kagouraki/PypilotRemote/3dparts/St70ScreenAdapter.STEP

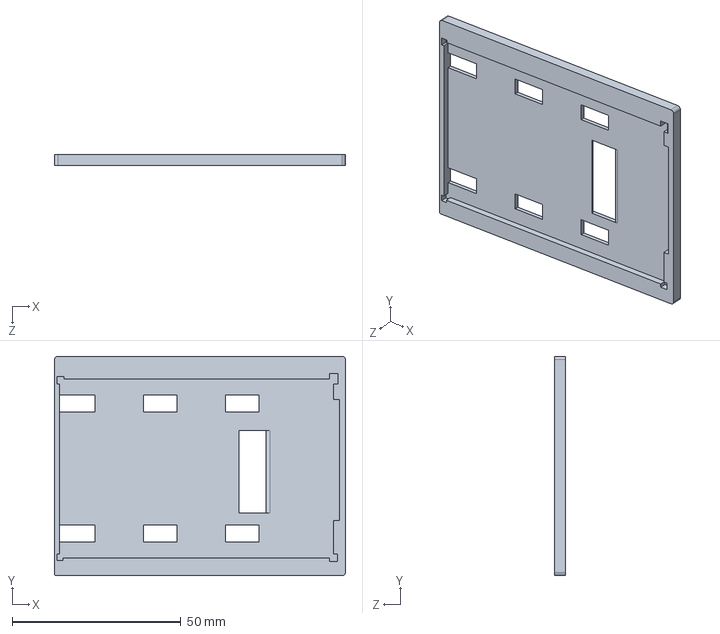
[picture p6: CAD file, 2026-01-31]
3dparts/St70ScreenAdapter.STEP
86.2 x 65.0 x 3.20 mm
