kagouraki/PypilotRemote/pcb/raymarineST70/st70Remote/schematic.pdf

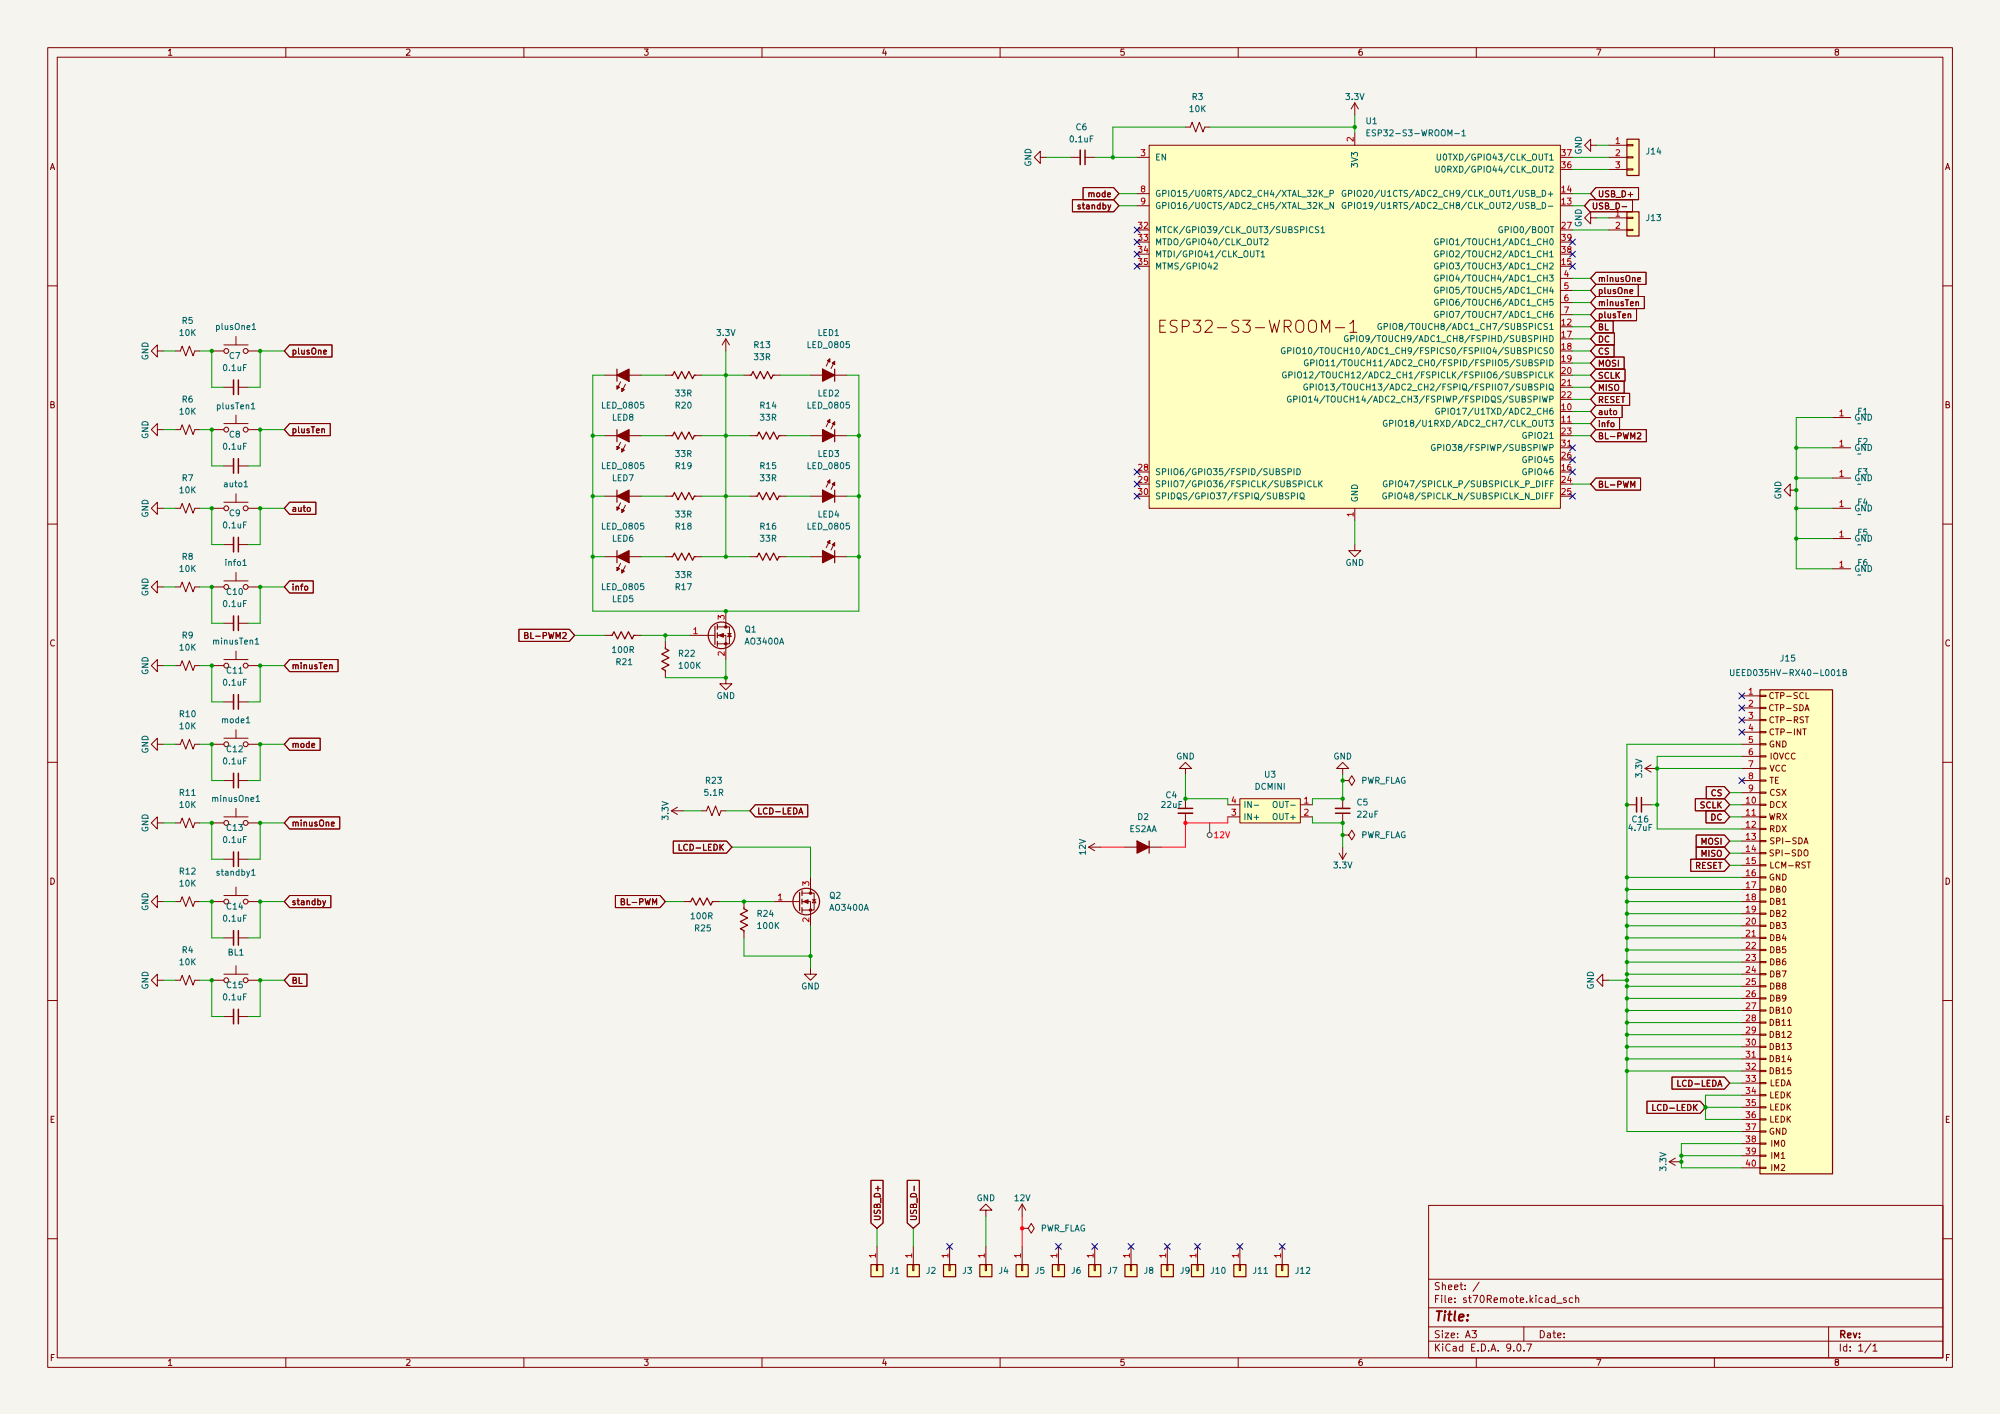
[picture p7: page 1]
