kagouraki/PypilotRemote/(list of files, drawings)

Other design files:
pcb/raymarineST70/st70Remote/freerouting.dsn
