kagouraki/PypilotRemote/pcb/raymarineST70/st70Remote/st70Remote.kicad_pcb

## KiCad design pcb/raymarineST70/st70Remote/st70Remote.kicad_pcb (2026-01-31)

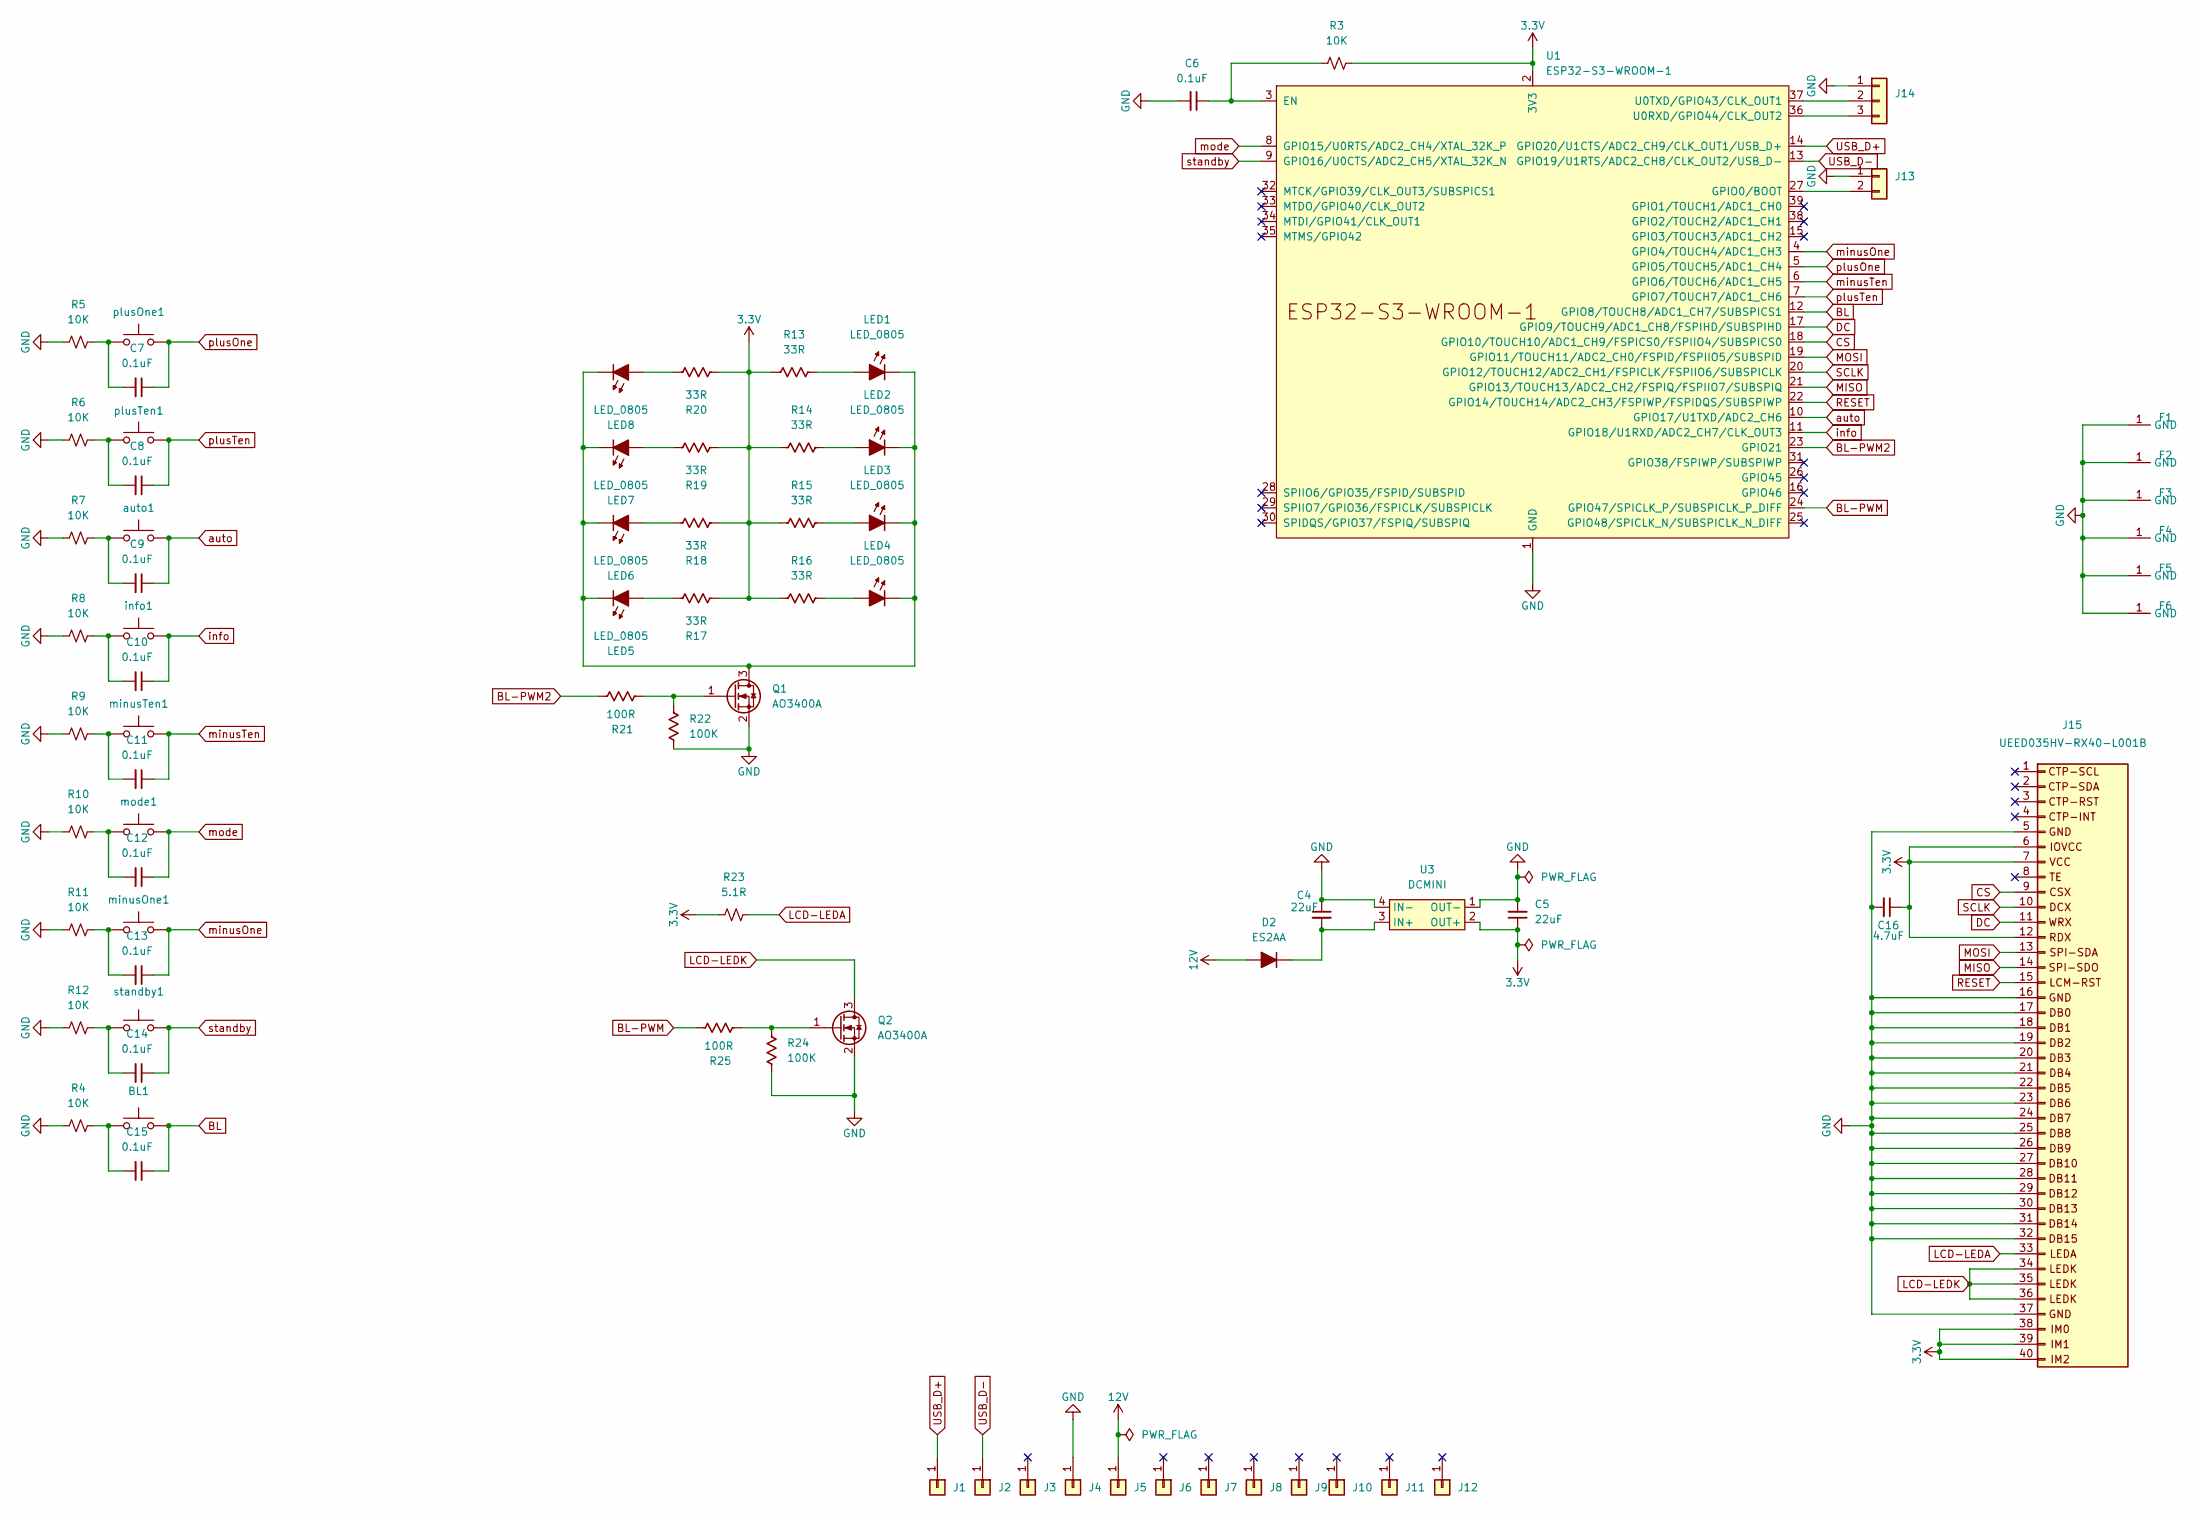
[picture p8: schematic st70Remote.kicad_sch]

Parts:
BL1: SMD_6.2x6.2mm_h7.0mm; Push_SMD_6.2x6.2mm; Mfg Part# 679-2384-2-ND
C4, C5: 22uF; C_1206_3216Metric_Pad1.42x1.75mm; Voltage 25V; Tolerance 10%
C6, C7, C8, C9, C10, C11, C12, C13, C14, C15: 0.1uF; C_0805_2012Metric; Voltage 25V; Tolerance 5%
C16: 4.7uF; C_0805_2012Metric; Voltage 25V; Tolerance 5%
D2: ES2AA; D_SMA
F1, F2, F3, F4, F5, F6: Harwin S1791-42R
J1, J2, J3, J4, J5, J6, J7, J8, J9, J10, J11, J12: Conn_01x01; 1x01_P2.54mm
J13: Conn_01x02; 1x02_P2.54mm
J14: Conn_01x03; 1x03_P2.54mm_Locking
J15: UEED035HV-RX40-L001B; XUNPU FPC-05F-40PH20
LED1, LED2, LED3, LED4, LED5, LED6, LED7, LED8: LED_0805; LED_0805_2012Metric
Q1, Q2: AO3400A; SOT-23
R3, R4, R5, R6, R7, R8, R9, R10, R11, R12: 10K; R_0805_2012Metric
R13, R14, R15, R16, R17, R18, R19, R20: 33R; R_0805_2012Metric
R21, R25: 100R; R_0805_2012Metric
R22, R24: 100K; R_0805_2012Metric
R23: 5.1R; R_0805_2012Metric
U1: ESP32-S3-WROOM-1; ESP32-S3-WROOM-1U
U3: DCMINI
auto1: SMD_6.2x6.2mm_h7.0mm; Push_SMD_6.2x6.2mm; Mfg Part# 679-2384-2-ND
info1: SMD_6.2x6.2mm_h7.0mm; Push_SMD_6.2x6.2mm; Mfg Part# 679-2384-2-ND
minusOne1: SMD_6.2x6.2mm_h7.0mm; Push_SMD_6.2x6.2mm; Mfg Part# 679-2384-2-ND
minusTen1: SMD_6.2x6.2mm_h7.0mm; Push_SMD_6.2x6.2mm; Mfg Part# 679-2384-2-ND
mode1: SMD_6.2x6.2mm_h7.0mm; Push_SMD_6.2x6.2mm; Mfg Part# 679-2384-2-ND
plusOne1: SMD_6.2x6.2mm_h7.0mm; Push_SMD_6.2x6.2mm; Mfg Part# 679-2384-2-ND
plusTen1: SMD_6.2x6.2mm_h7.0mm; Push_SMD_6.2x6.2mm; Mfg Part# 679-2384-2-ND
standby1: SMD_6.2x6.2mm_h7.0mm; Push_SMD_6.2x6.2mm; Mfg Part# 679-2384-2-ND

Connections:
3.3V: C5.1, C16.1, J15.6, J15.7, J15.12, J15.38, J15.39, J15.40, R3.1, R13.1, R14.1, R15.1, R16.1, R17.1, R18.1, R19.1, R20.1, R23.2, U1.2 (3V3), U3.2 (OUT+)
12V: D2.2 (A), J5.1
BL: BL1.2, C15.1, U1.12 (GPIO8/TOUCH8/ADC1_CH7/SUBSPICS1)
BL-PWM: R25.2, U1.24 (GPIO47/SPICLK_P/SUBSPICLK_P_DIFF)
BL-PWM2: R21.2, U1.23 (GPIO21)
CS: J15.9, U1.18 (GPIO10/TOUCH10/ADC1_CH9/FSPICS0/FSPIIO4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)
DC: J15.11, U1.17 (GPIO9/TOUCH9/ADC1_CH8/FSPIHD/SUBSPIHD)
GND: C4.1, C5.2, C6.2, C16.2, F1.1 (GND), F2.1 (GND), F3.1 (GND), F4.1 (GND), F5.1 (GND), F6.1 (GND), J4.1, J13.1, J14.1, J15.5, J15.16, J15.17, J15.18, J15.19, J15.20, J15.21, J15.22, J15.23, J15.24, J15.25, J15.26, J15.27, J15.28, J15.29, J15.30, J15.31, J15.32, J15.37, J15.41 (GND), Q1.2 (S), Q2.2 (S), R4.2, R5.2, R6.2, R7.2, R8.2, R9.2, R10.2, R11.2, R12.2, R22.2, R24.2, U1.1 (GND), U1.40 (GND), U1.41 (GND), U3.1 (OUT-), U3.4 (IN-)
LCD-LEDA: J15.33, R23.1
LCD-LEDK: J15.34, J15.35, J15.36, Q2.3 (D)
MISO: J15.14, U1.21 (GPIO13/TOUCH13/ADC2_CH2/FSPIQ/FSPIIO7/S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)
MOSI: J15.13, U1.19 (GPIO11/TOUCH11/ADC2_CH0/FSPID/FSPIIO5/S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)
unnamed: BL1.1, C15.2, R4.1
unnamed: C7.2, R5.1, plusOne1.1
unnamed: C8.2, R6.1, plusTen1.1
unnamed: C9.2, R7.1, auto1.1
unnamed: C10.2, R8.1, info1.1
unnamed: C11.2, R9.1, minusTen1.1
unnamed: C12.2, R10.1, mode1.1
unnamed: C13.2, R11.1, minusOne1.1
unnamed: C14.2, R12.1, standby1.1
unnamed: C4.2, D2.1 (K), U3.3 (IN+)
unnamed: J13.2, U1.27 (GPIO0/BOOT)
unnamed: J14.2, U1.37 (U0TXD/GPIO43/CLK_OUT1)
unnamed: J14.3, U1.36 (U0RXD/GPIO44/CLK_OUT2)
unnamed: LED1.2 (A), R13.2
unnamed: LED1.1 (K), LED2.1 (K), LED3.1 (K), LED4.1 (K), LED5.1 (K), LED6.1 (K), LED7.1 (K), LED8.1 (K), Q1.3 (D)
unnamed: LED2.2 (A), R14.2
unnamed: LED3.2 (A), R15.2
unnamed: LED4.2 (A), R16.2
unnamed: LED5.2 (A), R17.2
unnamed: LED6.2 (A), R18.2
unnamed: LED7.2 (A), R19.2
unnamed: LED8.2 (A), R20.2
unnamed: Q1.1 (G), R21.1, R22.1
unnamed: Q2.1 (G), R24.1, R25.1
unnamed: C6.1, R3.2, U1.3 (EN)
RESET: J15.15, U1.22 (GPIO14/TOUCH14/ADC2_CH3/FSPIWP/FSPIDQS/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)
SCLK: J15.10, U1.20 (GPIO12/TOUCH12/ADC2_CH1/FSPICLK/FSPIIO6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)
USB_D+: J1.1, U1.14 (GPIO20/U1CTS/ADC2_CH9/CLK_OUT1/USB_D+)
USB_D-: J2.1, U1.13 (GPIO19/U1RTS/ADC2_CH8/CLK_OUT2/USB_D-)
auto: C9.1, U1.10 (GPIO17/U1TXD/ADC2_CH6), auto1.2
info: C10.1, U1.11 (GPIO18/U1RXD/ADC2_CH7/CLK_OUT3), info1.2
minusOne: C13.1, U1.4 (GPIO4/TOUCH4/ADC1_CH3), minusOne1.2
minusTen: C11.1, U1.6 (GPIO6/TOUCH6/ADC1_CH5), minusTen1.2
mode: C12.1, U1.8 (GPIO15/U0RTS/ADC2_CH4/XTAL_32K_P), mode1.2
plusOne: C7.1, U1.5 (GPIO5/TOUCH5/ADC1_CH4), plusOne1.2
plusTen: C8.1, U1.7 (GPIO7/TOUCH7/ADC1_CH6), plusTen1.2
standby: C14.1, U1.9 (GPIO16/U0CTS/ADC2_CH5/XTAL_32K_N), standby1.2

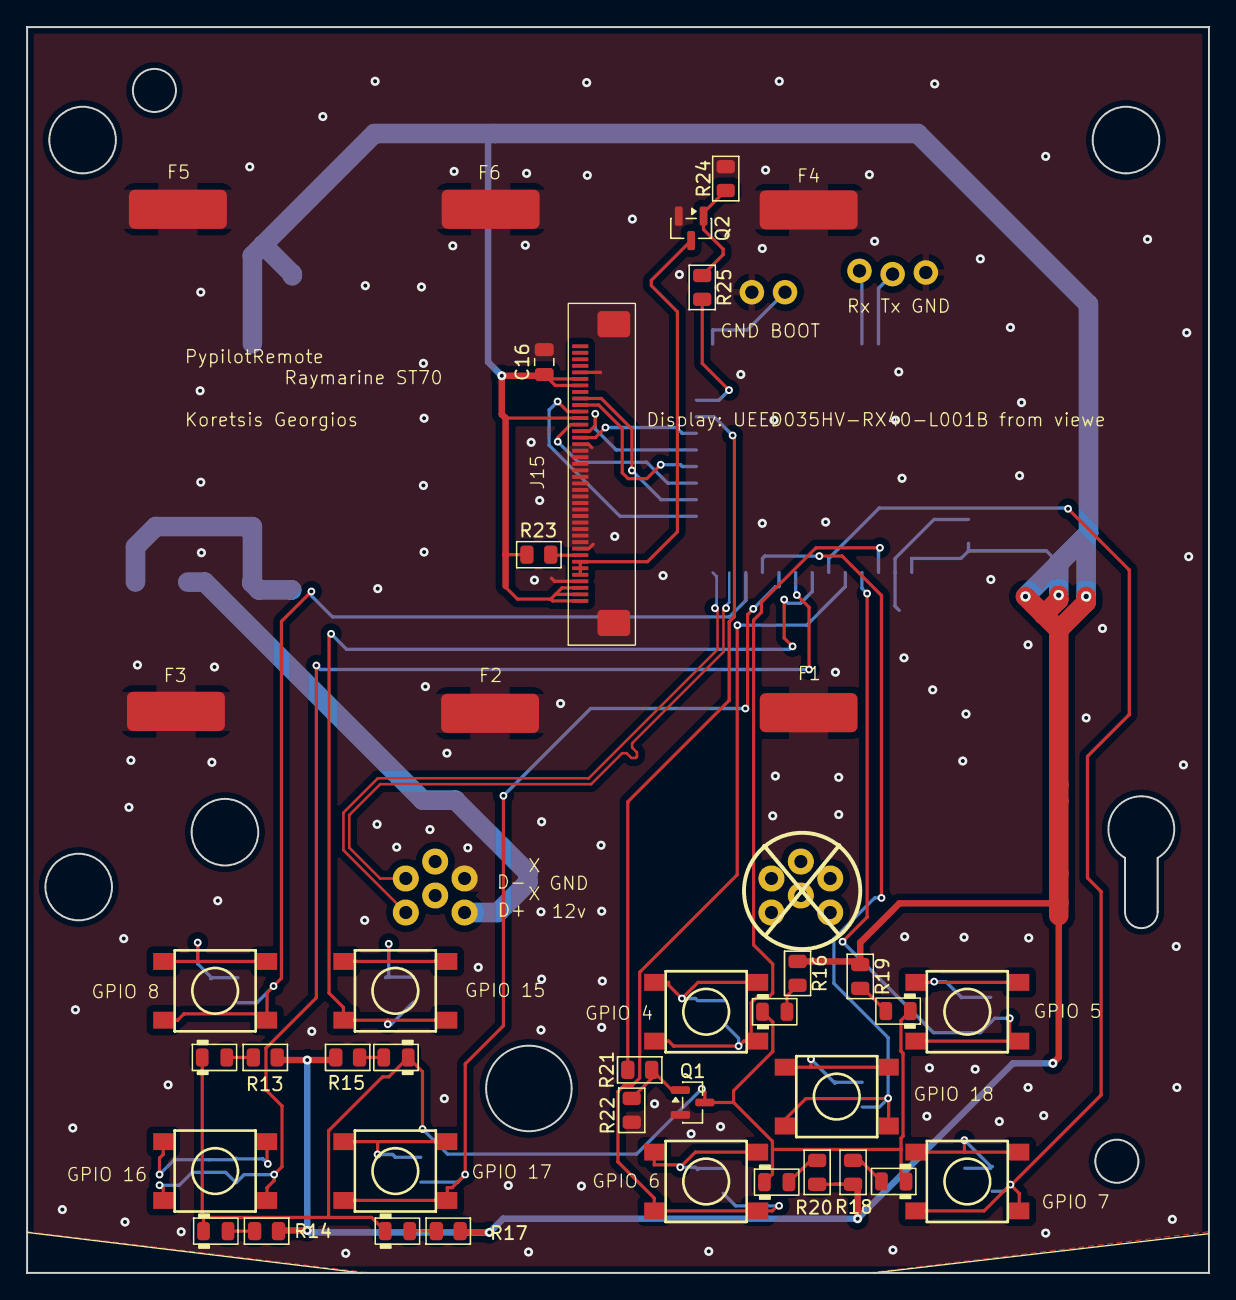
[picture p9: board st70Remote.kicad_pcb from above]

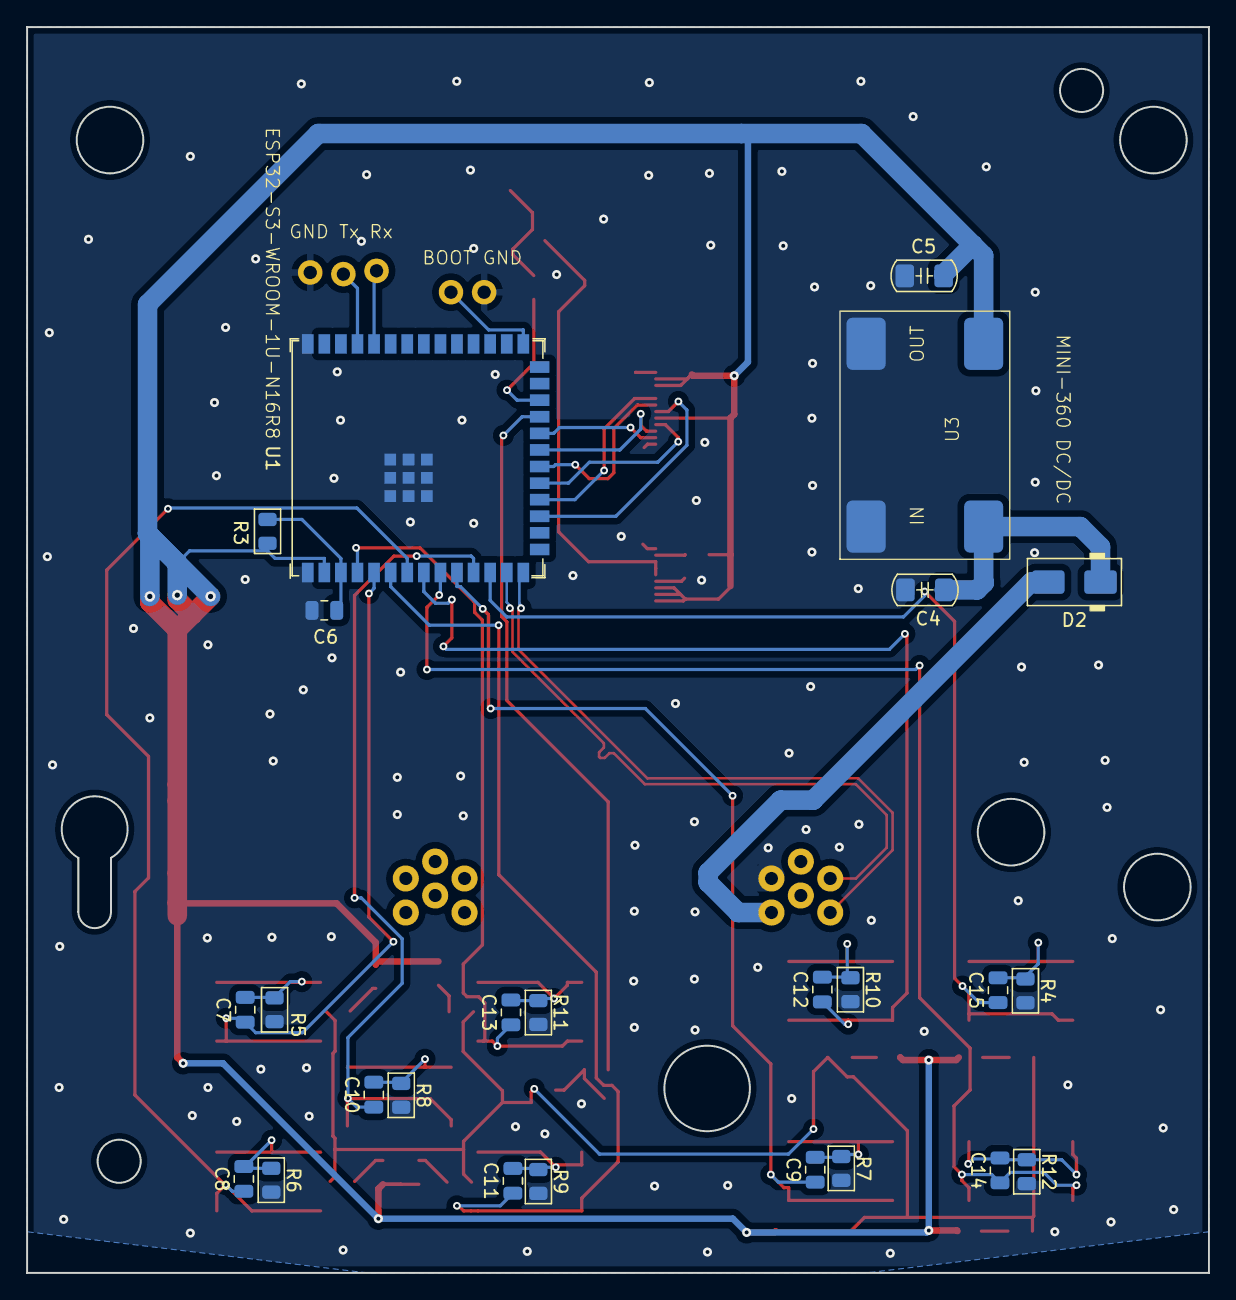
[picture p10: board st70Remote.kicad_pcb from below]

Board: 2 copper layers, 90.5 x 95.4 mm, 79 parts (27 on the bottom side), 49 nets.
