kagouraki/PypilotRemote/(commit log)

2026-01-31 Initial File commit
    [LCSCpartNum.csv, freerouting.dsn, partitions_16MB_ota.csv, st70Remote.kicad_pcb, st70Remote.kicad_sch]
2026-01-31 initial file commint Try2
    [bom.csv, designators.csv, freerouting.dsn, positions.csv, st70Remote.kicad_pcb, st70Remote.kicad_sch]
2026-01-31 initial file commit try3
    [partitions_16MB_ota.csv]
2026-01-31 Readme and files
    [LCSCpartNum.csv, St70ScreenAdapter.STEP]
2026-01-31 Add assembly section with link to wiki
    Added assembly guide link to README.
